MarcosAsh/HomeLab-PDU-Mon/enclosure/README.md

# HomeLab PDU Mon enclosure (1U, 10 inch, JLCCNC sheet metal)

Everything is generated by `enclosure.py` (parameters at the top).

    cd HomeLab-PDU-Mon
    .venv/bin/python enclosure/enclosure.py

It writes `tray.step lid.step front.step rear.step assembly.step marking.dxf`,
the PNG renders, and prints the interference and clearance report (about 25 s).
Coordinates follow SPEC.md (X = 0 centre line, Y = 0 inner face of the front panel, Z = 0 top of the floor).
STEP files for the four manufactured parts are the bent parts. `assembly.step` also holds placeholder
bodies (HRP-300, PCB, 6 modules and USB-C receptacles, fan, IEC, button, RJ45, PCB screw heads).

## Parts to order

| Part | File | Material | Thickness | Process | Finish | Qty |
|---|---|---|---|---|---|---|
| Tray (floor, 2 walls, flanges, tabs) | tray.step | 5052 | 1.2 | laser cut, 10 bends (2 long, 4 wall flanges and tabs, 4 floor tabs) | natural or clear anodise (see earthing) | 1 |
| Lid (plate, 2 side flanges, 2 rear tabs) | lid.step | 5052 | 1.2 | laser cut, bends | natural or clear anodise | 1 |
| Front panel with rack ears | front.step | 5052 | 2.0 | laser cut, flat, no bends | black anodise | 1 |
| Rear panel | rear.step + marking.dxf | 5052 | 1.2 | laser cut, flat, laser marking | black anodise | 1 |

Inside bend radius 1.2 (= t). Outside body 218.0 wide x 43.8 high x 248.0 deep, front panel makes 250.

How the parts join (all plain holes, no PEMs):
- Front panel: 4 M3 through the tray wall front flanges (inward, Z 8 and 26, X +-101.4) and 2 through floor tabs (X -46 and 0).
- Rear panel: 2 M3 through wall tabs (upper part only, Z 36, X +-101.4), 2 through floor tabs (X -98 and -2), 2 through the lid rear tabs (X 30 and 75, Z 35).
  The lower wall flange is omitted on the rear because module 6 and the PCB sit against the wall there.
- Lid: sits inside the walls, top flush. 4 M3 on the right wall (Y 30, 90, 150, 210) and 2 on the left wall (Y 14, 34).
  The left side only has the free front part: the HRP is 2.5 mm from the wall elsewhere and a nut would hit it.
- Nuts: plain M3 hex nuts on the inside of every flange and tab (JLCCNC lists no PEM inserts). Lid flange holes are 3.2, wall and panel holes 3.4.
  M3 rivet nuts are the alternative but their blind-side bulge is larger and they collide with the HRP on the left wall.

## Hardware BOM

| Item | Qty | Use |
|---|---|---|
| M3 x 8 button head (A2) | 6 | front panel (2.0 + 1.2 + nut) |
| M3 x 6 button head | 12 | rear panel 6, lid sides 6 |
| M3 hex nut | 22 | front 6, rear 6, lid 6, fan 4 |
| M3 x 25 + nut | 4 | 40 mm fan through the front panel (screw head outside, nut behind the fan) |
| M3 x 6 brass standoff, F-F, 6.0 | 6 | PCB, board bottom at Z = 6.0 |
| M3 x 5 button head (floor side) | 6 | standoff to floor, max 3.8 mm engagement |
| M3 x 6 pan head | 6 | PCB to standoff |
| M4 x 5 (max) | 4 | HRP bottom, floor 1.2 so 3.8 mm into the 5 mm max depth |
| M4 x 10, 2 x M4 star washer, M4 nut, ring lug | 1 | earth stud (see below) |
| M6 cage nuts and screws | 4 | rack mounting, not supplied here |

## Earthing (mains safety)

The tray is the earth bond. M4 earth hole (4.5 mm) on the floor at X 14, Y 42, next to the IEC inlet.
IEC earth pin goes there with a ring lug, and the HRP FG (terminal 3) goes to the same stud. Use a star washer on each side of the lug.
Anodising is an insulator. Ask JLCCNC to leave 12 mm dia bare around the earth hole (mask), or use chromate conversion on the tray and lid
if they offer it. Lid, panels and tray are bonded through the screws, so on anodised parts use star washers or mask the
contact faces. Do this before putting mains on it. Check continuity from the earth stud to the lid and both panels (< 0.1 ohm).

## Geometry summary

- Interior height 41.4 under the lid, HRP 41.0 so 0.4 mm spare. Floor top Z = 0, lid top Z = 42.6.
- Front: 254 x 44 panel centred on Z 20.7. Rack slots 9.5 x 6.5 at X +-118.25, 6.2 from top and bottom edge.
  RJ45 14.9 x 19.2 at X -60, button 16.2 at X -30, IEC 47.5 x 27.5 at X 32 (spec ~35), fan grille at X 77.5 (spec ~80),
  all at Z 20.7. Fan screw holes 32 x 32. Two groups of 4.0 mm slots over the HRP terminal end (7 mm pitch, 3.0 ribs = 1.5 x 2.0).
- Rear: 6 USB-C cutouts 15 x 8 rounded at X = 11.5 + 17 i, Z = 20.6 (PCB top 7.6 + 13.0). 40 hex vents (7 mm across flats, 2.0 web)
  over the HRP fan end X -88 to -10 plus 22 small 2.4 x 6 slots on the PCB side.
- Floor: 4 x 4.5 mm for the HRP (X -90.3 and -15.3, Y 80.3 and 200.3), 4 x 3.2 and 2 x 2.7 (M2.5) for the PCB standoffs (board holes (18,28) (86,28) (2.6,88.6) (101.4,88.6) (4,134.5) (101.4,113.4)), 1 x 4.5 earth. All 11 have a 90 degree underside countersink, see Open issues 2.

## Clearances (printed by the script)

    HRP fan end to rear panel inner face   4.00
    IEC body to HRP terminal end           13.93  (Y gap 10.80, X gap 8.80)
    Fan to PCB                             88.30
    PCB rear edge to rear panel            1.50   (0.30 to the tray rear floor tab)
    HRP top to lid underside               0.40
    Body width incl. lid flanges           218.00 (max 220.0)
    Body height                            43.80  (max 43.8)
    USB-C rim to receptacle, each side     3.03 (X) and 2.37 (Z), rib between cutouts 2.0
    J1 / J2 overhang to fan, IEC, RJ45     88.3 / 68.9 / 95.4 and 82.7 / 68.9 / 110.5 (HRP 10.0 and 31.2)
    Fan to PCB                             86.80 (PCB front edge is Y 106.8, not 108.3)

Interference: 30 bodies checked, 0 overlaps. The two rear PCB holes are M2.5 with 4.5 mm heads, which clear the 5.0 mm gap between modules.

## Renders

render_top.png, render_top_open.png (lid hidden), render_front.png, render_rear.png (seen from behind, X flipped),
render_iso.png, render_iso_open.png. They are made with a small z-buffer rasteriser in the script (no GUI needed).

## JLCCNC DFM notes

- Upload the STEP files. They are the bent parts, JLC unfolds them. If their quote tool wants flat DXF, the flat panels
  (front, rear) are plain plates, and for the tray and lid ask them to unfold with their K-factor.
- Tray and lid bend relief: every flange or tab is cut free of its neighbours (floor tabs have 1.2 x 2.4 relief notches either side,
  wall flanges start 2.4 above the floor and stop 1.2 below the wall top).
- Flange flat length at least 4 t + r = 6.0. Used: wall flanges 8.6, floor tabs 8.8, lid flanges 9.6, lid rear tabs 9.6.
- Hole edge to bend tangent at least 2 t + r = 3.6. Used exactly 3.6 on the wall flange, floor tab and lid flange holes.
  If JLC measures to the bend line rather than the tangent this is 1.2 mm more margin, so fine. If they want more, move the
  hole centres 0.5 mm inwards, there is room (flange end margin is 1.8, the 1.5 t minimum).
- Min hole diameter 3.2, USB-C slot 8 high, all above max(0.5 t, 1).
- Rear marking: `marking.dxf` holds the flat rear panel seen from outside (u = -X) with layer CUT (outline and holes) and layer MARK (port numbers 1 to 6,
  "HomeLab PDU Mon", "Marcos Ashton Iglesias 2026-10-28"). The text is glyph outline (double line) with 0.2 mm polyline width,
  text height 4.5 (numbers), 2.6 and 2.0 (lines). A STEP cannot carry a marking layer, so keep rear.step for the cut and
  use the DXF for the marking. Laser marking on black anodise gives light text. Check that 2.0 mm text is accepted, if not
  raise it to 2.5.
- Anodising and tolerances: sheet cut and bend tolerance is about +-0.2 per feature, bends +-0.5 degree. The 0.3 mm lid-to-wall gap is deliberate.
  Order one spare lid and one spare tray set for the first run.

## Assumptions

- USB-C receptacle centre 13.0 mm above PCB top (Z 20.6). I could not measure it in the Shrike CAD (their PD module is not modelled,
  only a 22.9 mm tall slot in their printed rear). See the report for how this was sanity checked.
- Module body is a 12 x 33 x 22 box, its rear face 0.8 mm in front of the rear panel inner face, receptacle shell 8.94 x 3.26 passes through the cutout.
- Only the front panel is 2.0, all else 1.2 as in the spec.

## Decision needed: floor screw heads (floor is 1.2 mm in these files)

All 11 floor holes are modelled with a 90 degree underside countersink, as deep as the sheet allows. The sheet is too thin for flush M3 and M4 heads.
Heads under the floor add to the 43.8 body height.

| Screw | Head dia | Depth for flush | Floor hole | Result at 1.2 mm floor |
|---|---|---|---|---|
| M2.5 countersunk (2 rear PCB holes) | 5.0 | 1.15 | 2.7 | flush, 0.05 land (very thin edge) |
| M3 countersunk (4 PCB holes) | 6.0 | 1.40 | 3.2 | knife edge, head about 0.2 mm proud |
| M4 countersunk (4 HRP holes and earth) | 8.0 | 1.75 | 4.5 | knife edge, head about 0.55 mm proud |

Option A, accept slightly proud heads: keep the 1.2 mm floor and the countersinks as modelled. Underside protrusion 0.2 mm (M3) and 0.55 mm (M4),
so the real height with heads is 43.8 + 0.55 = 44.35 at the HRP screws. Cheapest, but the countersink has no land, so ask JLCCNC whether they accept it.
Using M3 and M4 low-head cap screws instead is worse (1.65 to 2.8 mm proud).

Option B, dimples (extruded or formed countersinks, in the 1.2 mm sheet): head sits flush or nearly so because the cone is pressed down into the sheet,
and the dimple depth is not limited by the sheet thickness. Needs JLCCNC to confirm they can form it in 1.2 mm 5052. Body height stays 43.8.
The part would need the dimple formed on the underside, and the floor above gets a raised cone of about 0.5 to 0.8 mm in the M3 and M4 places,
which must clear the HRP and PCB standoff seats (the standoff and HRP sit on the raised cone, so check their flatness).

Option C, 1.5 mm floor (not applied): M3 becomes flush (needs 1.4), M4 is still 0.25 mm proud (needs 1.75). The floor is 0.3 mm thicker. Either the body becomes 44.1
(over the 43.8 limit and the 44.0 front panel) or the interior drops to 41.1 and the HRP (41.0) has 0.1 mm to the lid, too tight.

My suggestion: ask JLCCNC about dimples first, fall back to A.

## Open issues

1. Rear PCB holes (board (18,28), (86,28)) are M2.5: 2.7 mm floor holes, M2.5 x 6 standoffs, 4.5 mm heads on top. Other 4 PCB holes stay M3.
2. Countersunk floor screws: see Decision needed above.
3. USB-C cutout is now 15 x 8 (2.0 mm rib between ports, limit 1.8), receptacle margin 3.03 in X and 2.37 in Z.
4. J1 and J2 overhang placeholders: Y 101.9 to 106.8, Z from PCB top to PCB top + 13 (I read '~13' as height above the PCB top, conservative).
   All clear: nearest is the HRP at 10.0 (J1).
5. SPEC.md inconsistency: PCB is 138.5 long, so its front edge is Y = 245.3 - 138.5 = 106.8, but SPEC says Y 108.3 to 245.3. The model uses 106.8.
