MarcosAsh/HomeLab-PDU-Mon/enclosure/render_front.png

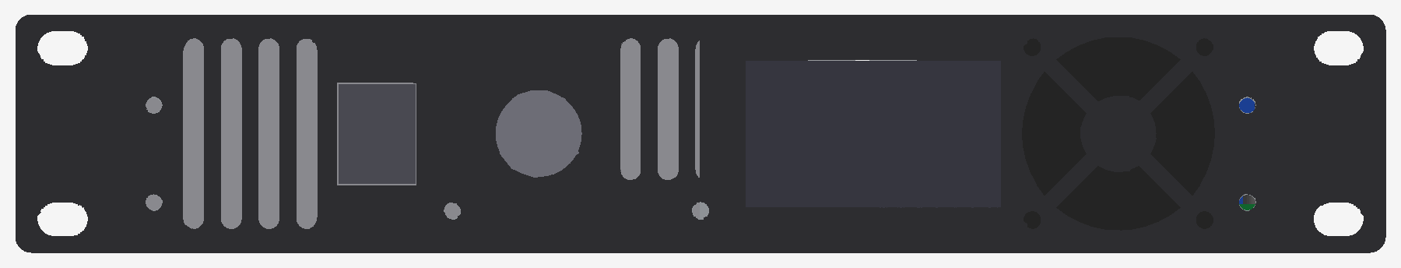
enclosure/render_front.png
