MarcosAsh/HomeLab-PDU-Mon/enclosure/render_iso.png

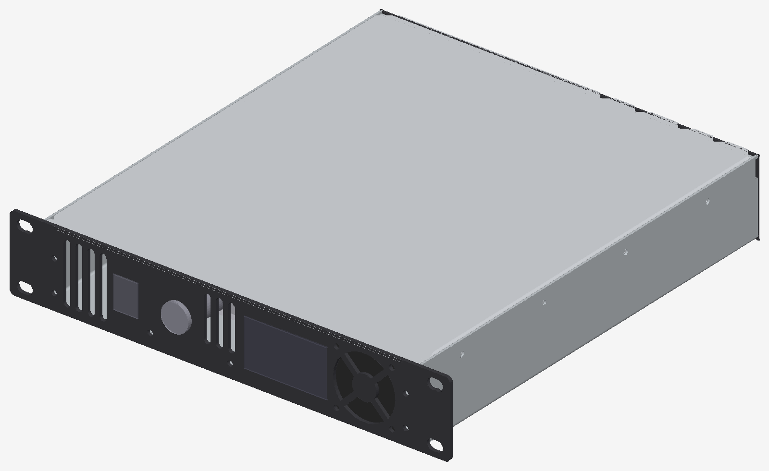
enclosure/render_iso.png
