MarcosAsh/HomeLab-PDU-Mon/enclosure/render_iso_open.png

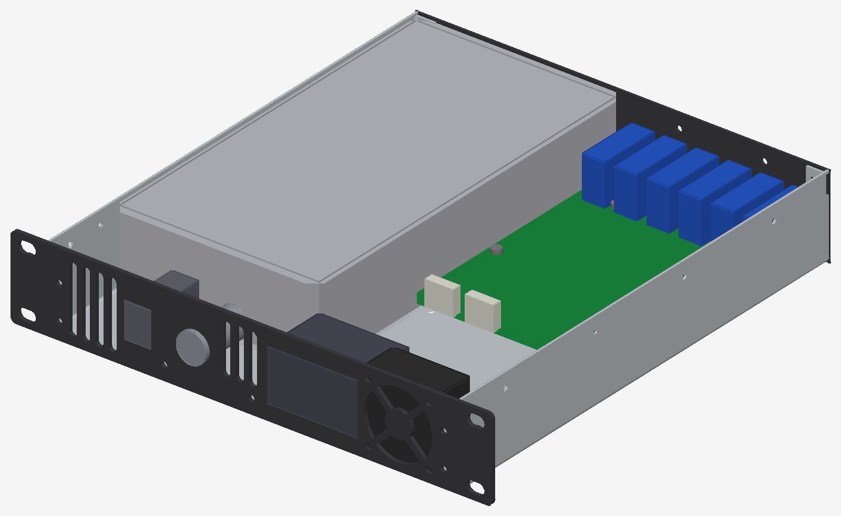
enclosure/render_iso_open.png
