MarcosAsh/HomeLab-PDU-Mon/enclosure/render_rear.png

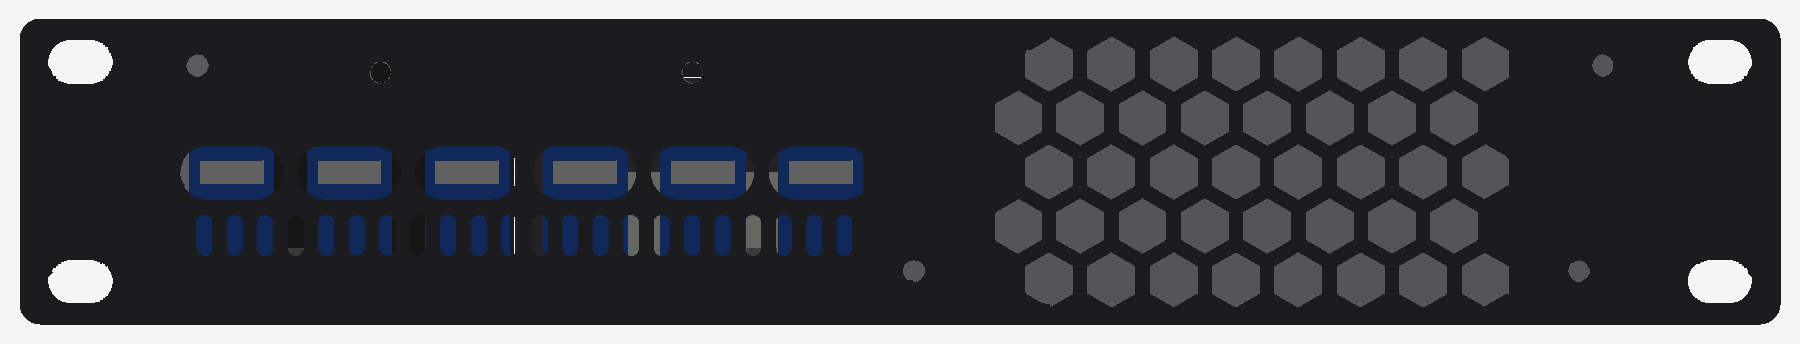
enclosure/render_rear.png
