MarcosAsh/HomeLab-PDU-Mon/enclosure/render_top.png

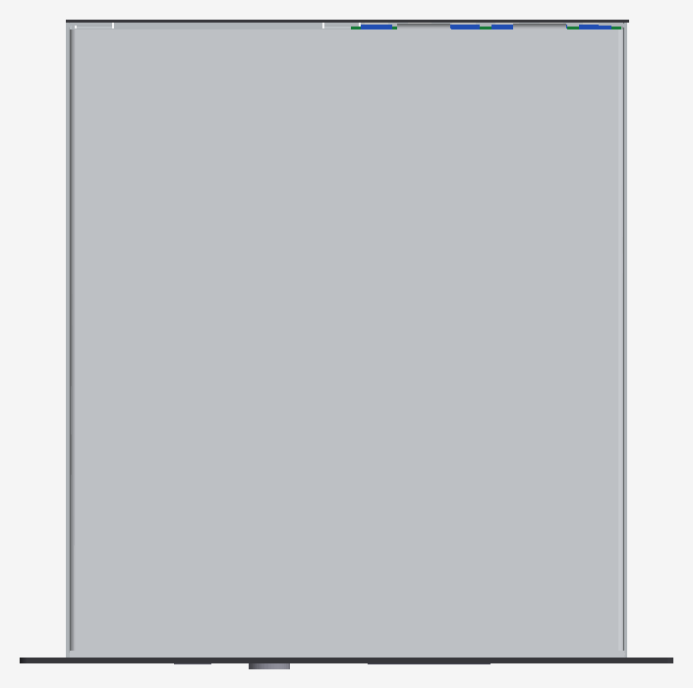
enclosure/render_top.png
