MarcosAsh/HomeLab-PDU-Mon/enclosure/render_top_open.png

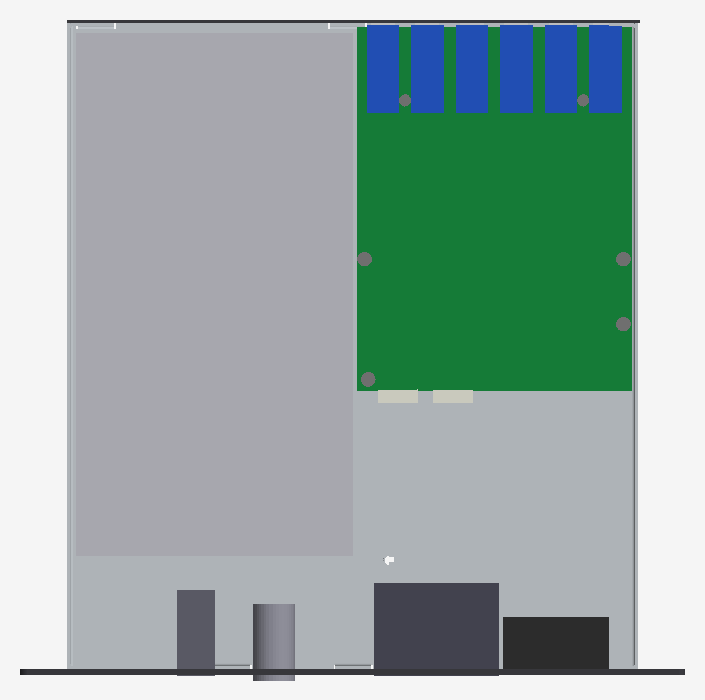
enclosure/render_top_open.png
