MarcosAsh/HomeLab-PDU-Mon/pcb/place.png

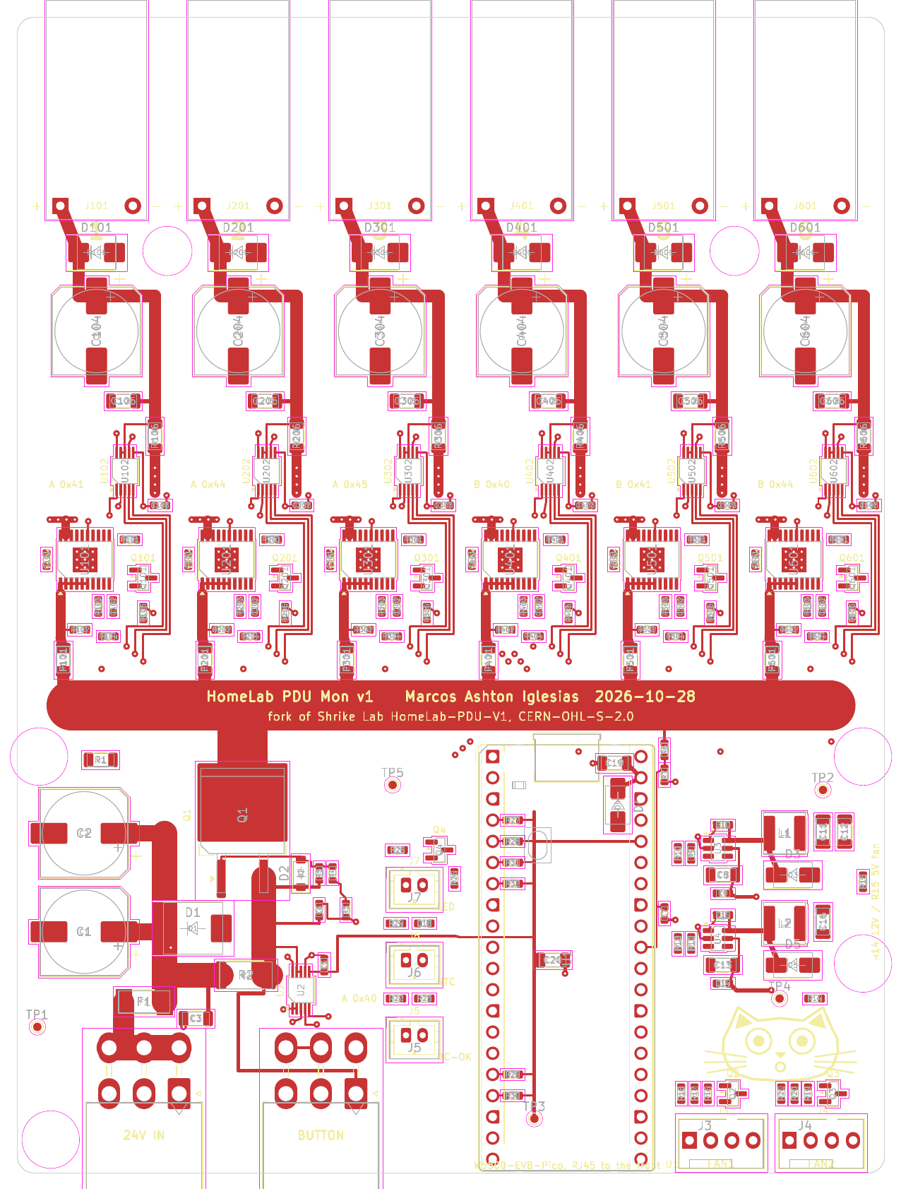
pcb/place.png
