MarcosAsh/HomeLab-PDU-Mon/pcb/renders/B_Cu.png

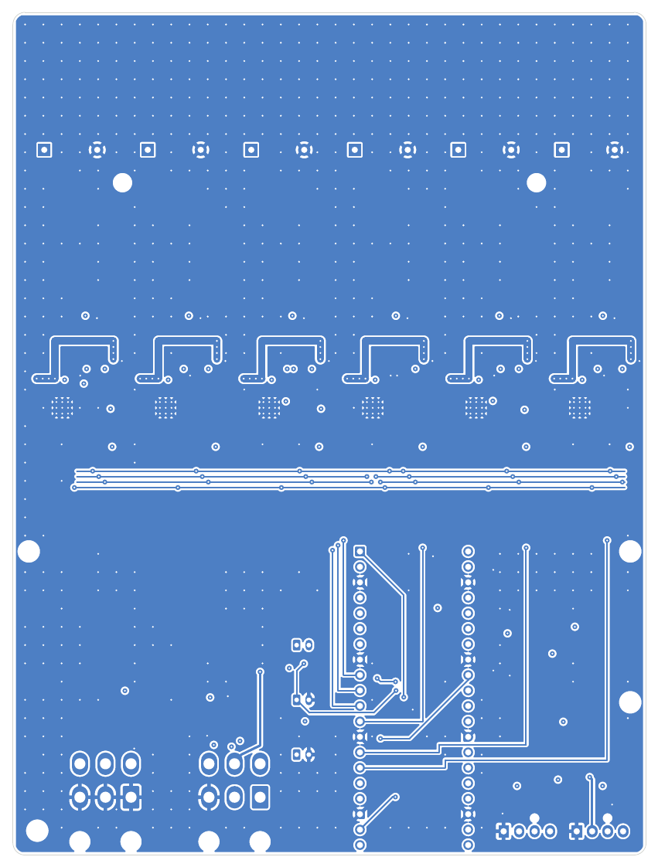
pcb/renders/B_Cu.png
