MarcosAsh/HomeLab-PDU-Mon/pcb/renders/F_Cu.png

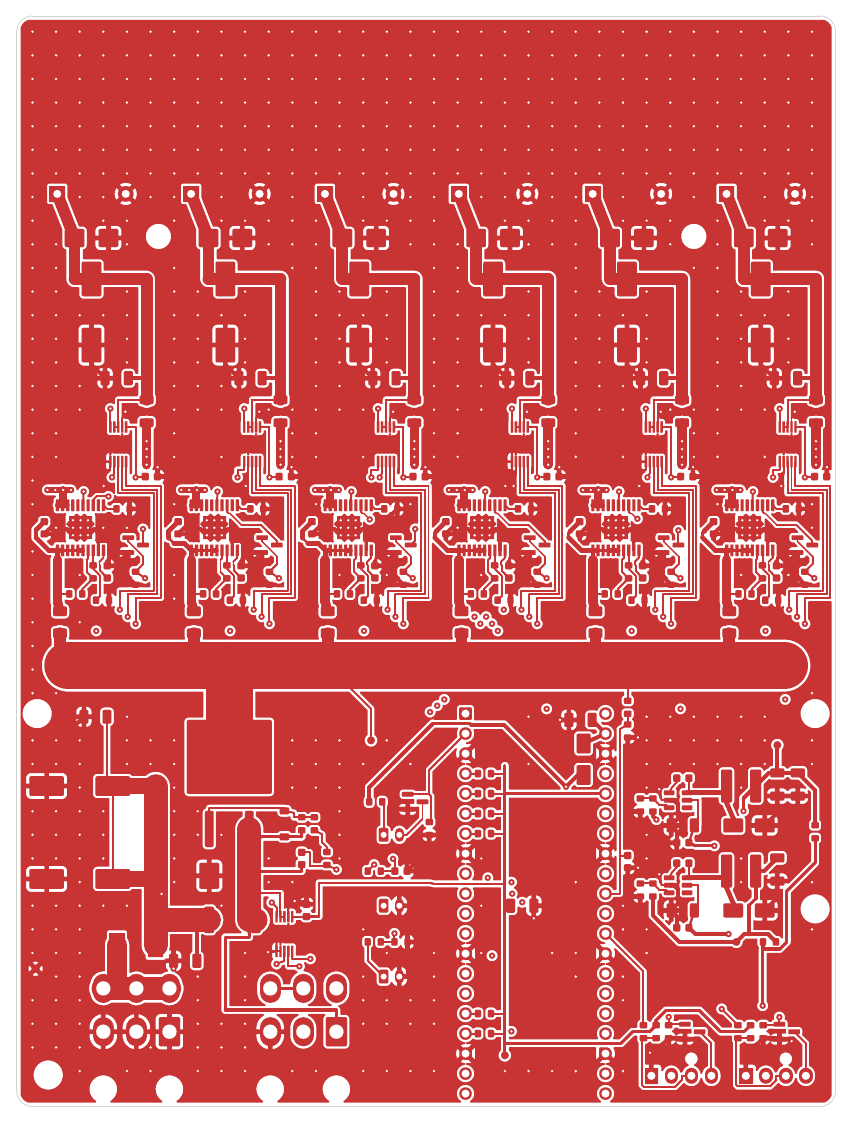
pcb/renders/F_Cu.png
