MarcosAsh/HomeLab-PDU-Mon/pcb/renders/F_Cu_Silk.png

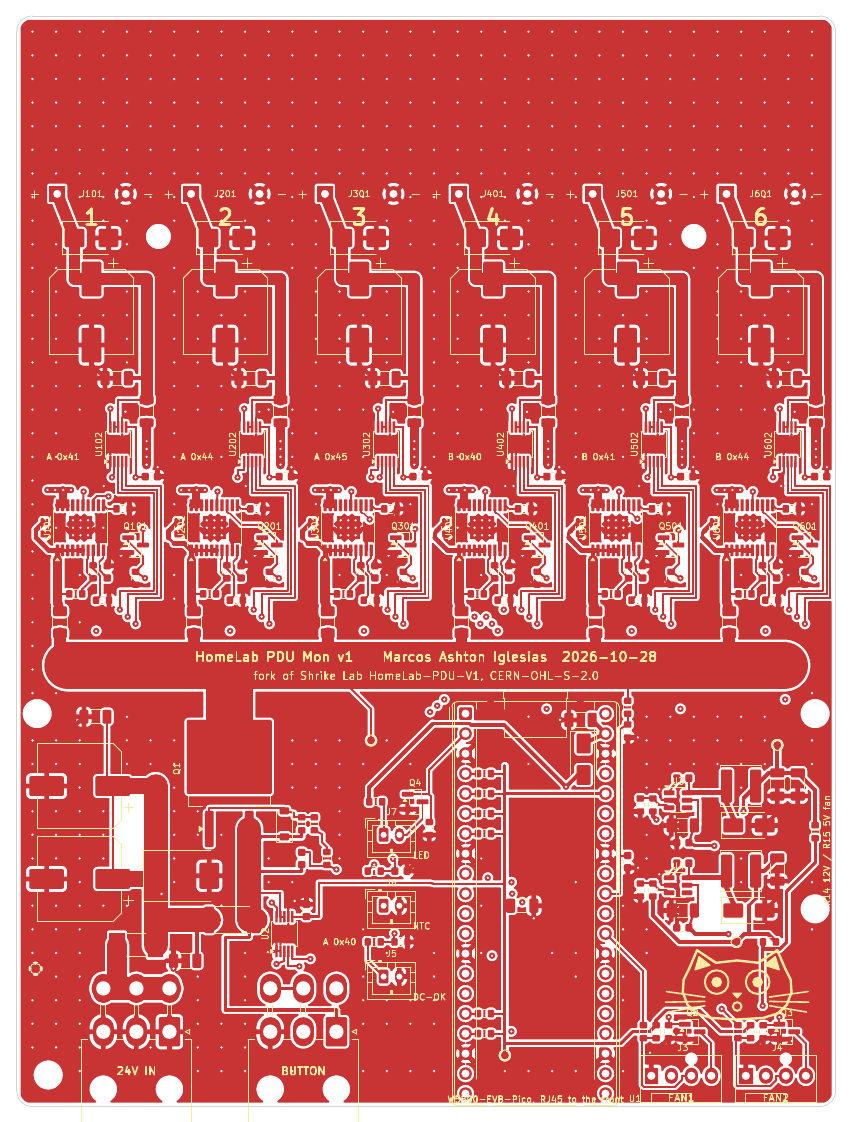
pcb/renders/F_Cu_Silk.png
