MarcosAsh/HomeLab-PDU-Mon/pcb/renders/F_Silk.png

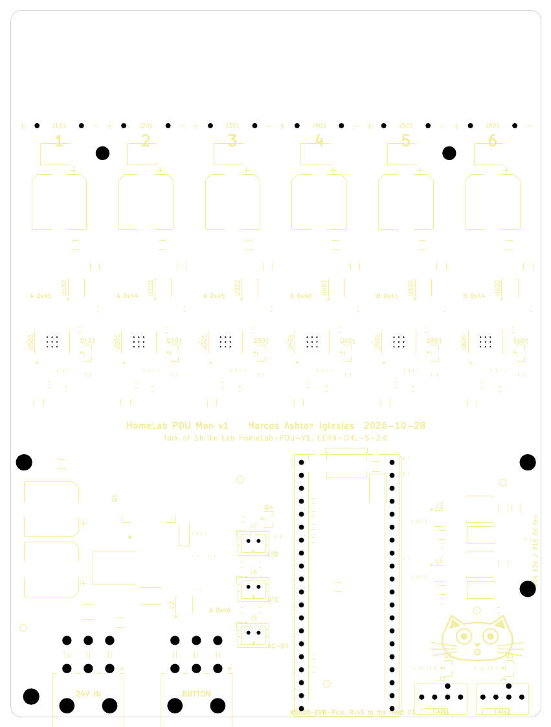
pcb/renders/F_Silk.png
