MarcosAsh/HomeLab-PDU-Mon/pcb/renders/Fab.png

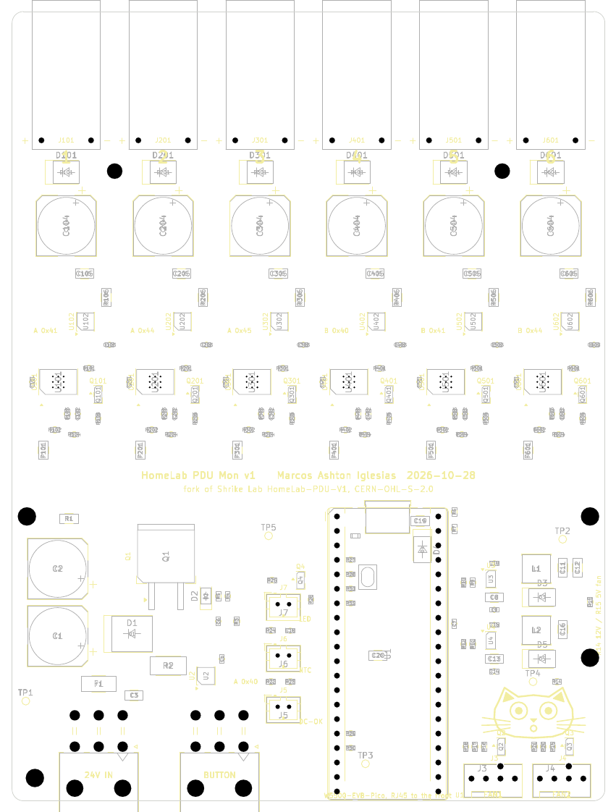
pcb/renders/Fab.png
