MarcosAsh/HomeLab-PDU-Mon/pcb/renders/render_bottom.png

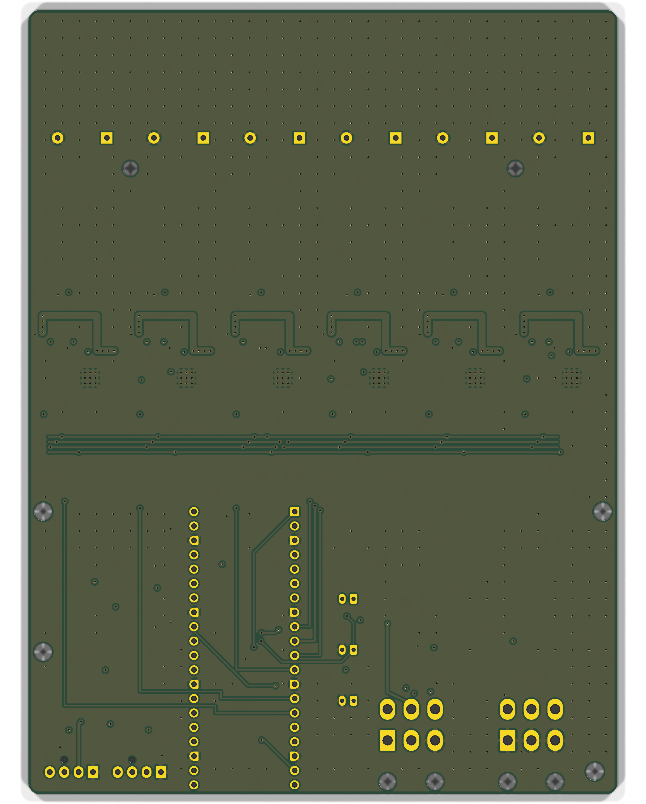
pcb/renders/render_bottom.png
