MarcosAsh/HomeLab-PDU-Mon/enclosure/assembly.step

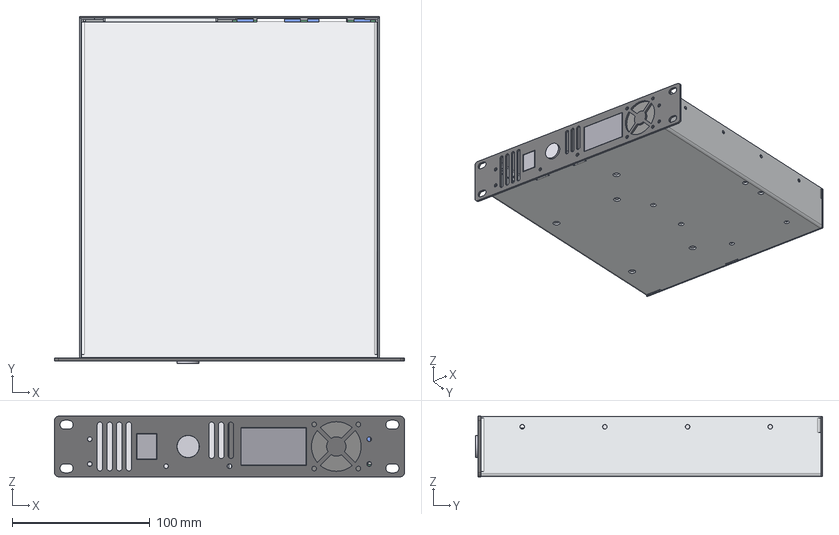
[picture p15: CAD file, 2026-10-29]
enclosure/assembly.step
254.0 x 252.0 x 44.0 mm
tray
lid
front
rear
HRP-300
PCB
PD module 1
USB-C 1
PD module 2
USB-C 2
PD module 3
USB-C 3
PD module 4
USB-C 4
PD module 5
USB-C 5
PD module 6
USB-C 6
PCB screw head 1
PCB screw head 2
PCB screw head 3
PCB screw head 4
PCB screw head 5
PCB screw head 6
J1 Mini-Fit (overhang)
J2 Mini-Fit (overhang)
Fan 40x40x20
IEC inlet
Button 16mm
RJ45 coupler
