MarcosAsh/HomeLab-PDU-Mon/pcb/out/pdu.step

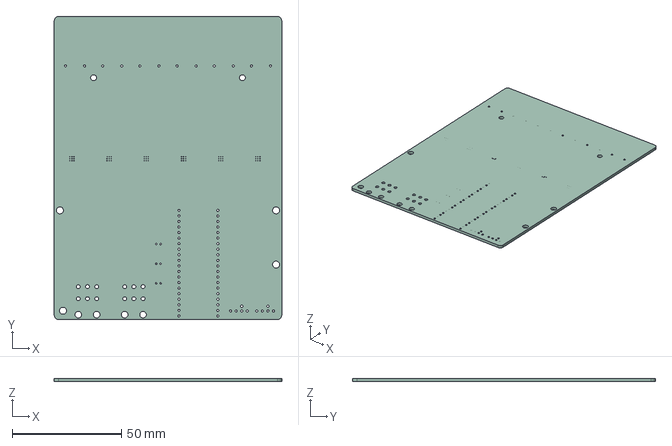
[picture p16: CAD file, 2026-10-29]
pcb/out/pdu.step
104.0 x 138.5 x 1.51 mm
