MarcosAsh/HomeLab-PDU-Mon/enclosure/tray.step

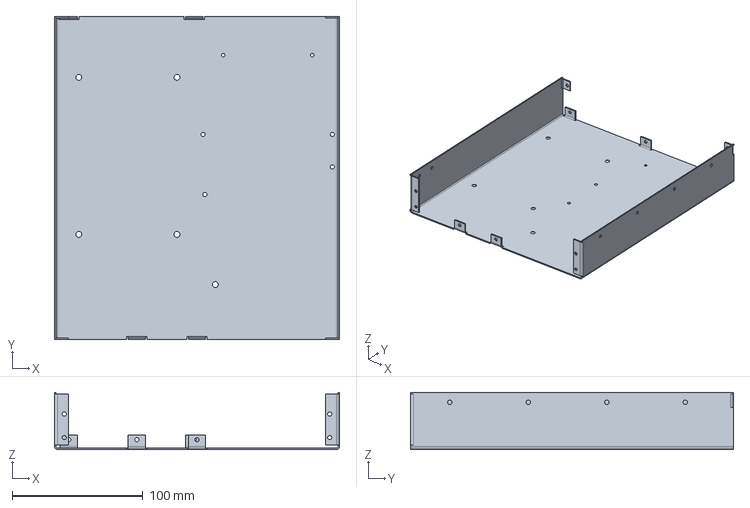
[picture p17: CAD file, 2026-10-29]
enclosure/tray.step
218.0 x 246.8 x 43.8 mm
