MarcosAsh/HomeLab-PDU-Mon/enclosure/lid.step

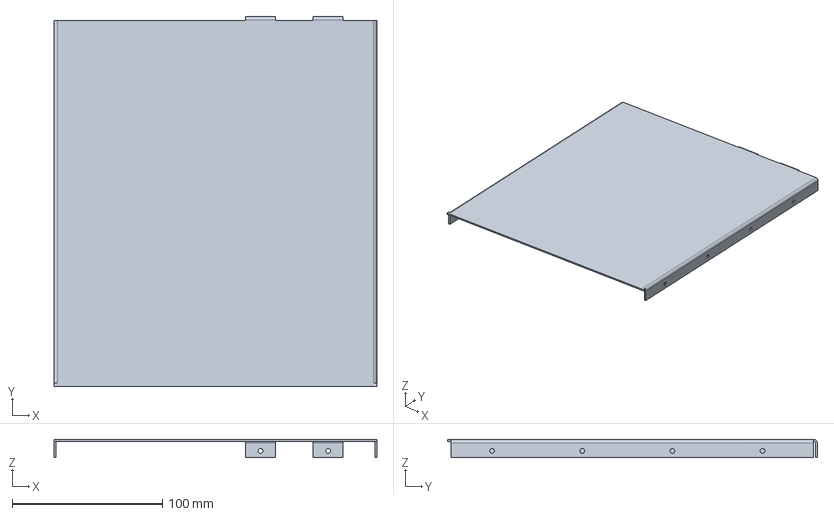
[picture p18: CAD file, 2026-10-29]
enclosure/lid.step
215.0 x 246.3 x 12.0 mm
