MarcosAsh/HomeLab-PDU-Mon/enclosure/front.step

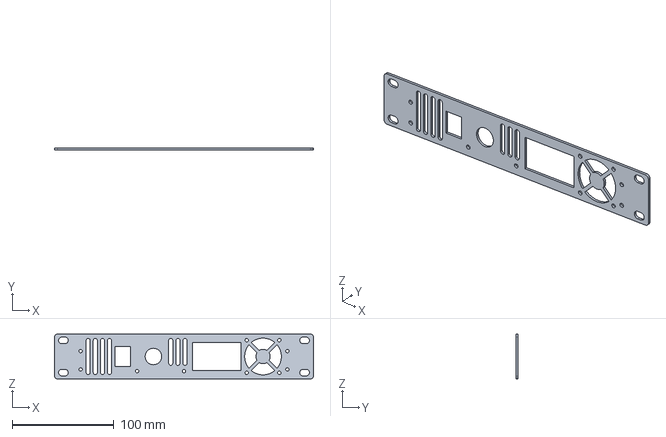
[picture p19: CAD file, 2026-10-29]
enclosure/front.step
254.0 x 2.00 x 44.0 mm
