MarcosAsh/HomeLab-PDU-Mon/enclosure/marking.dxf

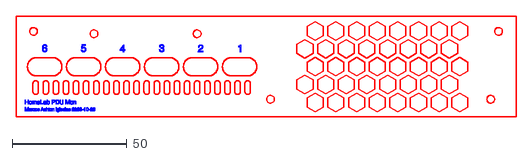
[picture p20: CAD file, 2026-10-29]
enclosure/marking.dxf
218.0 x 43.8
