MarcosAsh/HomeLab-PDU-Mon/enclosure/rear.step

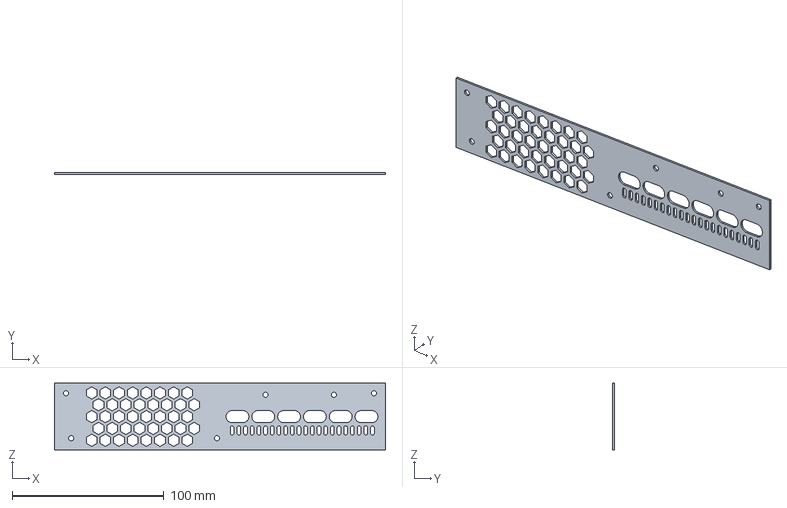
[picture p21: CAD file, 2026-10-29]
enclosure/rear.step
218.0 x 1.20 x 43.8 mm
