MarcosAsh/HomeLab-PDU-Mon/pcb/pdu.kicad_pcb

## KiCad design pcb/pdu.kicad_pcb (2026-10-29)

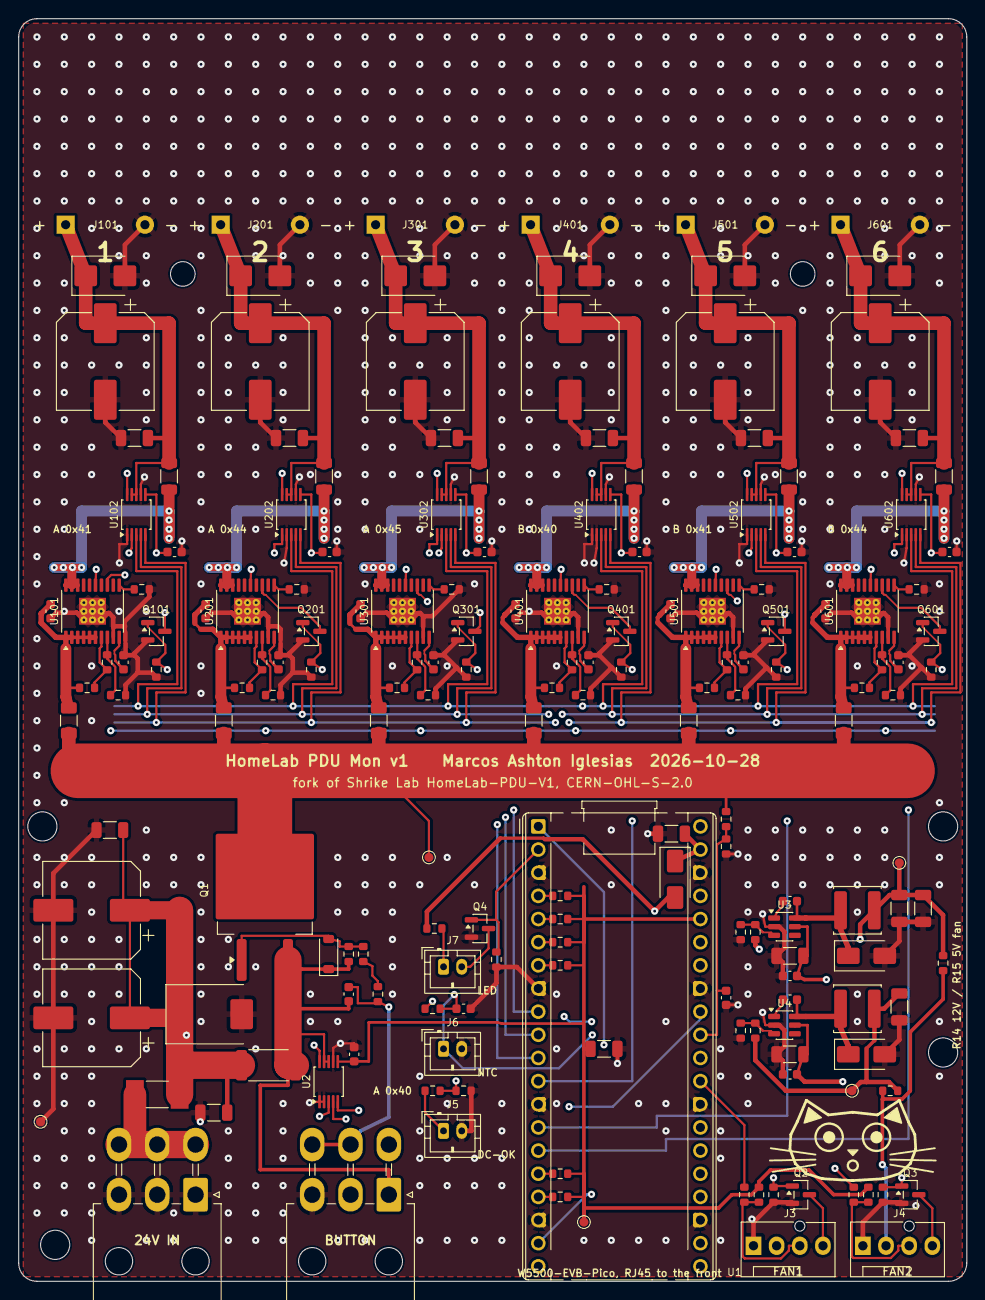
[picture p22: board pdu.kicad_pcb from above]

Board: 4 copper layers, 104.0 x 138.5 mm, 184 parts (0 on the bottom side), 95 nets.

Parts:
C1, C2, C104, C204, C304, C404, C504, C604: 470u; CP_Elec_10x10.5
C3, C105, C205, C305, C405, C505, C605: 1u; C_1206_3216Metric
C5, C7, C9, C10, C14, C15, C18, C101, C103, C201, C203, C301, C303, C401, C403, C501, C503, C601, C603: 100n; C_0603_1608Metric
C6: 220n; C_0603_1608Metric
C8, C13: 2u2; C_1206_3216Metric
C11, C12, C16: 22u; C_1206_3216Metric
C19, C20: 10u; C_1206_3216Metric
C102, C202, C302, C402, C502, C602: 56n; C_0603_1608Metric
D1: SMCJ26A; D_SMC
D2: 12V; D_SOD-123
D3, D4, D5: SS14; D_SMA
D101, D201, D301, D401, D501, D601: SMBJ26A; D_SMB
F1: 15A; Fuse_Littelfuse-NANO2-451_453
F101, F201, F301, F401, F501, F601: 5A; Fuse_1206_3216Metric
H1, H2: M2.5; MountingHole_2.7mm_M2.5
H3, H4, H5, H6: M3; MountingHole_3.2mm_M3
J1: 24V IN; Molex_Mini-Fit_Jr_5569-06A2_2x03_P4.20mm_Horizontal
J2: BUTTON; Molex_Mini-Fit_Jr_5569-06A2_2x03_P4.20mm_Horizontal
J3: FAN1; FanPinHeader_1x04_P2.54mm_Vertical
J4: FAN2; FanPinHeader_1x04_P2.54mm_Vertical
J5: DC-OK; JST_PH_B2B-PH-K_1x02_P2.00mm_Vertical
J6: NTC; JST_PH_B2B-PH-K_1x02_P2.00mm_Vertical
J7: LED; JST_PH_B2B-PH-K_1x02_P2.00mm_Vertical
J101: PD1; PD_Module_XPM52C_Standing
J201: PD2; PD_Module_XPM52C_Standing
J301: PD3; PD_Module_XPM52C_Standing
J401: PD4; PD_Module_XPM52C_Standing
J501: PD5; PD_Module_XPM52C_Standing
J601: PD6; PD_Module_XPM52C_Standing
L1: 33u; L_Sunlord_SWPA5040S
L2: 47u; L_Sunlord_SWPA5040S
Q1: NCEP40PT15D; TO-263-2
Q2, Q3, Q4, Q101, Q201, Q301, Q401, Q501, Q601: 2N7002; SOT-23
R1: 4k7; R_1206_3216Metric
R2: 2m; R_2512_6332Metric
R3: 47k; R_0603_1608Metric
R4: 100R; R_0603_1608Metric
R5, R6, R16, R19, R26, R105, R205, R305, R405, R505, R605: 100k; R_0603_1608Metric
R7, R10, R12, R17, R20, R24, R29, R30: 10k; R_0603_1608Metric
R9: 56k; R_0603_1608Metric
R11: 147k; R_0603_1608Metric
R14, R15: 0R; R_0603_1608Metric
R18, R21: 1k; R_0603_1608Metric
R22: 15k; R_0603_1608Metric
R23, R104, R204, R304, R404, R504, R604: 20k; R_0603_1608Metric
R25: 220R; R_0603_1608Metric
R27, R28, R31, R32: 4k7; R_0603_1608Metric
R101, R201, R301, R401, R501, R601: 4k53; R_0603_1608Metric
R102, R202, R302, R402, R502, R602: 442k; R_0603_1608Metric
R103, R203, R303, R403, R503, R603: 8k06; R_0603_1608Metric
R106, R206, R306, R406, R506, R606: 10m; R_1206_3216Metric
TP1: GND; TestPoint_Pad_D1.0mm
TP2: +5V; TestPoint_Pad_D1.0mm
TP3: +3V3; TestPoint_Pad_D1.0mm
TP4: +12V; TestPoint_Pad_D1.0mm
TP5: +24V_SW; TestPoint_Pad_D1.0mm
U1: W5500-EVB-Pico; RaspberryPi_Pico_Common_THT
U2, U102, U202, U302, U402, U502, U602: INA237; VSSOP-10_3x3mm_P0.5mm
U3, U4: LMR16006X; TSOT-23-6
U101, U201, U301, U401, U501, U601: TPS16630; HTSSOP-20-1EP_4.4x6.5mm_P0.65mm_EP2.96x2.96mm_ThermalVias

Connections:
+3V3: C5.1, C20.2, C103.1, C203.1, C303.1, C403.1, C503.1, C603.1, R17.2, R20.2, R27.2, R28.2, R29.2, R30.2, R31.2, R32.2, TP3.1, U1.36, U2.6, U102.2, U102.6, U202.1, U202.6, U302.1, U302.2, U302.6, U402.6, U502.2, U502.6, U602.1, U602.6
+5V: C11.2, C12.2, D4.2, L1.2, R9.1, R15.2, R25.1, TP2.1
+12V: C16.2, L2.2, R11.1, R14.2, TP4.1
+24V: C6.1, C8.2, C9.2, C13.2, C14.2, D2.1, J2.1, Q1.3, R2.1, R5.2, U2.8, U2.9, U3.5, U4.5
+24V_F: C1.1, C2.1, C3.2, D1.1, F1.2, R1.2, R2.2, U2.10
+24V_RAW: F1.1, J1.4, J1.5, J1.6
+24V_SW: F101.1, F201.1, F301.1, F401.1, F501.1, F601.1, Q1.2, R6.2, TP5.1
ADC_VREF: R24.1, U1.35
ALERT_N: R30.1, U1.17, U2.3, U102.3, U202.3, U302.3, U402.3, U502.3, U602.3
B5_CB: C10.1, U3.1
B5_FB: R9.2, R10.2, U3.3
B5_SW: C10.2, D3.1, L1.1, U3.6
B12_CB: C15.1, U4.1
B12_FB: R11.2, R12.2, U4.3
B12_SW: C15.2, D5.1, L2.1, U4.6
BTN: C6.2, J2.5, J2.6, R3.2
DCOK: R22.2, R23.1, U1.32
DCOK_IN: J5.1, R22.1
FAN1_PWM: J3.4, Q2.3
FAN1_PWMC: Q2.1, R16.2, U1.19
FAN1_TACH: R18.2, U1.29
FAN1_TACHR: J3.3, R17.1, R18.1
FAN2_PWM: J4.4, Q3.3
FAN2_PWMC: Q3.1, R19.2, U1.20
FAN2_TACH: R21.2, U1.1
FAN2_TACHR: J4.3, R20.1, R21.1
FLT_N: R29.1, U1.16, U101.15, U201.15, U301.15, U401.15, U501.15, U601.15
GND: C1.2, C2.2, C3.1, C5.2, C7.1, C8.1, C9.1, C11.1, C12.1, C13.1, C14.1, C16.1, C18.2, C19.1, C20.1, C101.1, C102.2, C103.2, C104.2, C105.1, C201.1, C202.2, C203.2, C204.2, C205.1, C301.1, C302.2, C303.2, C304.2, C305.1, C401.1, C402.2, C403.2, C404.2, C405.1, C501.1, C502.2, C503.2, C504.2, C505.1, C601.1, C602.2, C603.2, C604.2, C605.1, D1.2, D3.2, D5.2, D101.2, D201.2, D301.2, D401.2, D501.2, D601.2, J1.1, J1.2, J1.3, J2.3, J3.1, J4.1, J5.2, J6.2, J101.2, J201.2, J301.2, J401.2, J501.2, J601.2, Q2.2, Q3.2, Q4.2, Q101.2, Q201.2, Q301.2, Q401.2, Q501.2, Q601.2, R1.1, R7.1, R10.1, R12.1, R16.1, R19.1, R23.2, R26.1, R101.2, R104.2, R105.1, R201.2, R204.2, R205.1, R301.2, R304.2, R305.1, R401.2, R404.2, R405.1, R501.2, R504.2, R505.1, R601.2, R604.2, R605.1, TP1.1, U1.3, U1.8, U1.13, U1.18, U1.23, U1.28, U1.33, U1.38, U2.1, U2.2, U2.7, U3.2, U4.2, U101.9, U101.21, U102.1, U102.7, U201.9, U201.21, U202.2, U202.7, U301.9, U301.21, U302.7, U401.9, U401.21, U402.1, U402.2, U402.7, U501.9, U501.21, U502.1, U502.7, U601.9, U601.21, U602.2, U602.7
LED_A: J7.1, R25.2
LED_CTL: Q4.1, R26.2, U1.2
LED_K: J7.2, Q4.3
NTC: C18.1, J6.1, R24.2, U1.34
P1_DVDT: C102.1, U101.10
P1_EF: R106.1, U101.18, U101.19, U101.20, U102.10
P1_ILIM: R101.1, U101.11
P1_IN: C101.2, F101.2, R102.1, U101.1, U101.2, U101.3, U101.4, U101.5, U101.6
P1_OFF: Q101.1, R105.2, U1.11
P1_OUT: C104.1, C105.2, D101.1, J101.1, R106.2, U102.8, U102.9
P1_OVP: R103.2, R104.1, U101.8
P1_SHDN: Q101.3, U101.13
P1_UVLO: R102.2, R103.1, U101.7
P2_DVDT: C202.1, U201.10
P2_EF: R206.1, U201.18, U201.19, U201.20, U202.10
P2_ILIM: R201.1, U201.11
P2_IN: C201.2, F201.2, R202.1, U201.1, U201.2, U201.3, U201.4, U201.5, U201.6
P2_OFF: Q201.1, R205.2, U1.10
P2_OUT: C204.1, C205.2, D201.1, J201.1, R206.2, U202.8, U202.9
P2_OVP: R203.2, R204.1, U201.8
P2_SHDN: Q201.3, U201.13
P2_UVLO: R202.2, R203.1, U201.7
P3_DVDT: C302.1, U301.10
P3_EF: R306.1, U301.18, U301.19, U301.20, U302.10
P3_ILIM: R301.1, U301.11
P3_IN: C301.2, F301.2, R302.1, U301.1, U301.2, U301.3, U301.4, U301.5, U301.6
P3_OFF: Q301.1, R305.2, U1.9
P3_OUT: C304.1, C305.2, D301.1, J301.1, R306.2, U302.8, U302.9
P3_OVP: R303.2, R304.1, U301.8
P3_SHDN: Q301.3, U301.13
P3_UVLO: R302.2, R303.1, U301.7
P4_DVDT: C402.1, U401.10
P4_EF: R406.1, U401.18, U401.19, U401.20, U402.10
P4_ILIM: R401.1, U401.11
P4_IN: C401.2, F401.2, R402.1, U401.1, U401.2, U401.3, U401.4, U401.5, U401.6
P4_OFF: Q401.1, R405.2, U1.12
P4_OUT: C404.1, C405.2, D401.1, J401.1, R406.2, U402.8, U402.9
P4_OVP: R403.2, R404.1, U401.8
P4_SHDN: Q401.3, U401.13
P4_UVLO: R402.2, R403.1, U401.7
P5_DVDT: C502.1, U501.10
P5_EF: R506.1, U501.18, U501.19, U501.20, U502.10
P5_ILIM: R501.1, U501.11
P5_IN: C501.2, F501.2, R502.1, U501.1, U501.2, U501.3, U501.4, U501.5, U501.6
P5_OFF: Q501.1, R505.2, U1.14
P5_OUT: C504.1, C505.2, D501.1, J501.1, R506.2, U502.8, U502.9
P5_OVP: R503.2, R504.1, U501.8
P5_SHDN: Q501.3, U501.13
P5_UVLO: R502.2, R503.1, U501.7
P6_DVDT: C602.1, U601.10
P6_EF: R606.1, U601.18, U601.19, U601.20, U602.10
P6_ILIM: R601.1, U601.11
P6_IN: C601.2, F601.2, R602.1, U601.1, U601.2, U601.3, U601.4, U601.5, U601.6
P6_OFF: Q601.1, R605.2, U1.15
P6_OUT: C604.1, C605.2, D601.1, J601.1, R606.2, U602.8, U602.9
P6_OVP: R603.2, R604.1, U601.8
P6_SHDN: Q601.3, U601.13
P6_UVLO: R602.2, R603.1, U601.7
Q1_G: D2.2, Q1.1, R4.1, R5.1
Q1_GR: R3.1, R4.2
SCL: R28.1, U1.5, U2.5, U102.5, U202.5, U302.5
SCL_B: R32.1, U1.7, U402.5, U502.5, U602.5
SDA: R27.1, U1.4, U2.4, U102.4, U202.4, U302.4
SDA_B: R31.1, U1.6, U402.4, U502.4, U602.4
SW_SENSE: C7.2, R6.1, R7.2, U1.31
VFAN: J3.2, J4.2, R14.1, R15.1
VSYS: C19.2, D4.1, U1.39
