MarcosAsh/HomeLab-PDU-Mon/firmware/build.rs

use std::{env, fs, path::PathBuf};

fn main() {
    let out = PathBuf::from(env::var_os("OUT_DIR").unwrap());
    fs::write(out.join("memory.x"), include_bytes!("memory.x")).unwrap();
    println!("cargo:rustc-link-search={}", out.display());
    println!("cargo:rerun-if-changed=memory.x");
    println!("cargo:rustc-link-arg-bins=--nmagic");
    println!("cargo:rustc-link-arg-bins=-Tlink.x");
    println!("cargo:rustc-link-arg-bins=-Tlink-rp.x");
}
