MarcosAsh/HomeLab-PDU-Mon/(commit log)

2026-10-29 HomeLab PDU Mon v1 board and enclosure
    [assembly.step, bom.csv, front.step, jlc_bom.csv, lid.step, marking.dxf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]
2026-10-29 Firmware: Rust/Embassy, Prometheus metrics and port switching
